Minarinski/2024ESWContest_free_1079/README.md

# 2024ESWContest_free_1079

## IoT-VehiCALL은 승객의 버스 탑승을 돕는 "승차벨" 시스템입니다.
### 대중교통 이용을 편리하게 하며, 교통약자의 접근성을 향상하고 버스 노선 운영을 효율적으로 할 수 있도록 합니다.
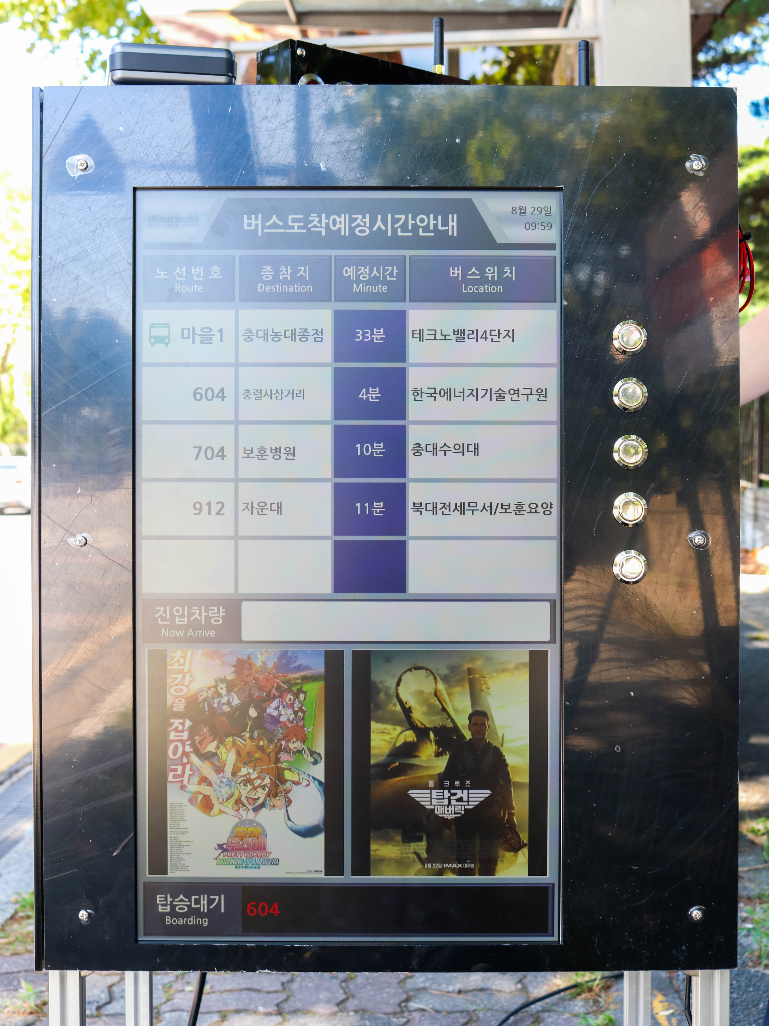
[picture p1: Remote_Device.jpg]

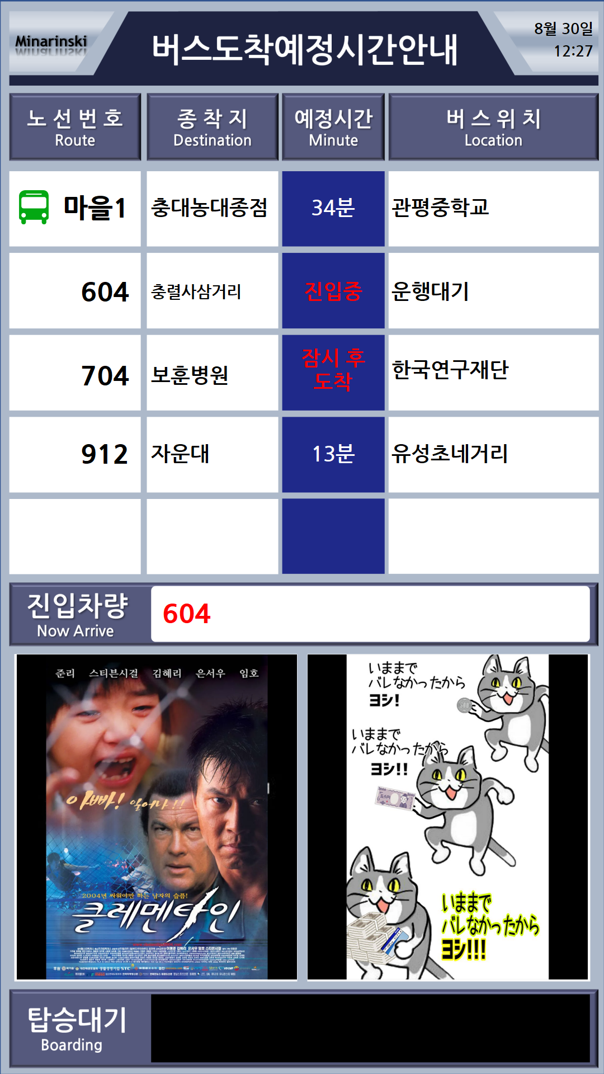
[picture p2: PyQt_GUI.PNG]

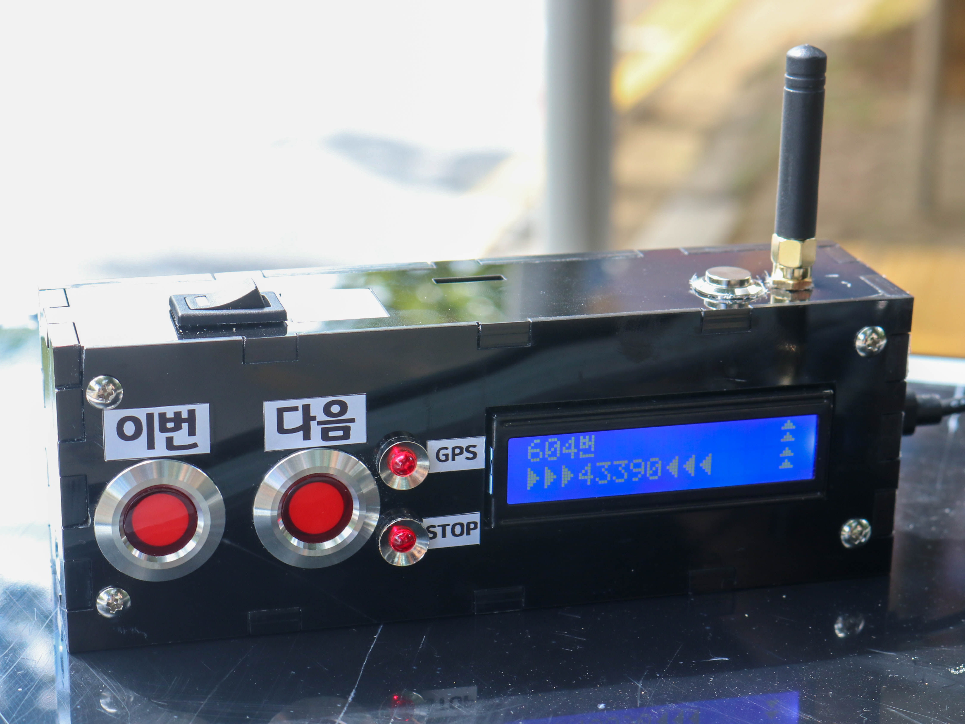
[picture p3: Local_Device.jpg]

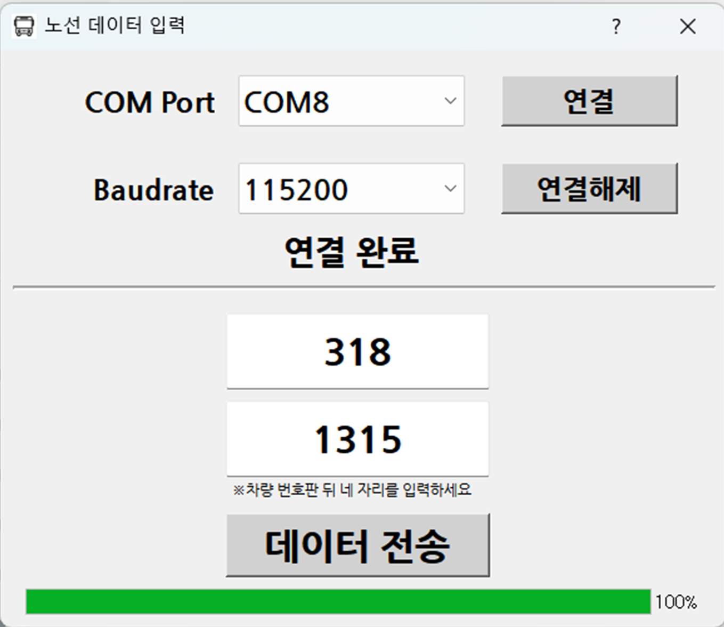
[picture p4: Bus_Data_Downloader.png]
