Minarinski/2024ESWContest_free_1079/PCB_Board/README.md

3D_View
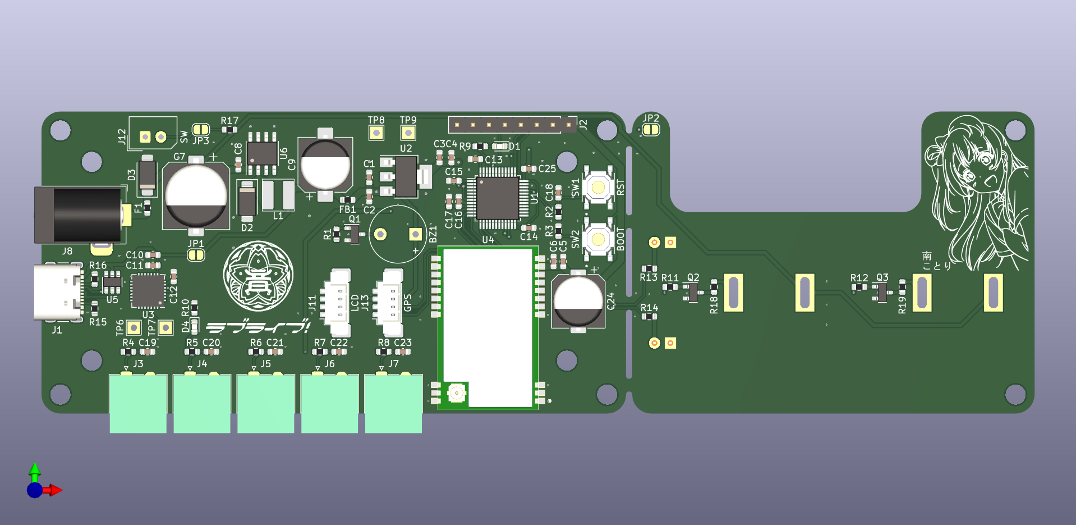
[picture p5: PCB_Board/3D_View.png]
3D_View

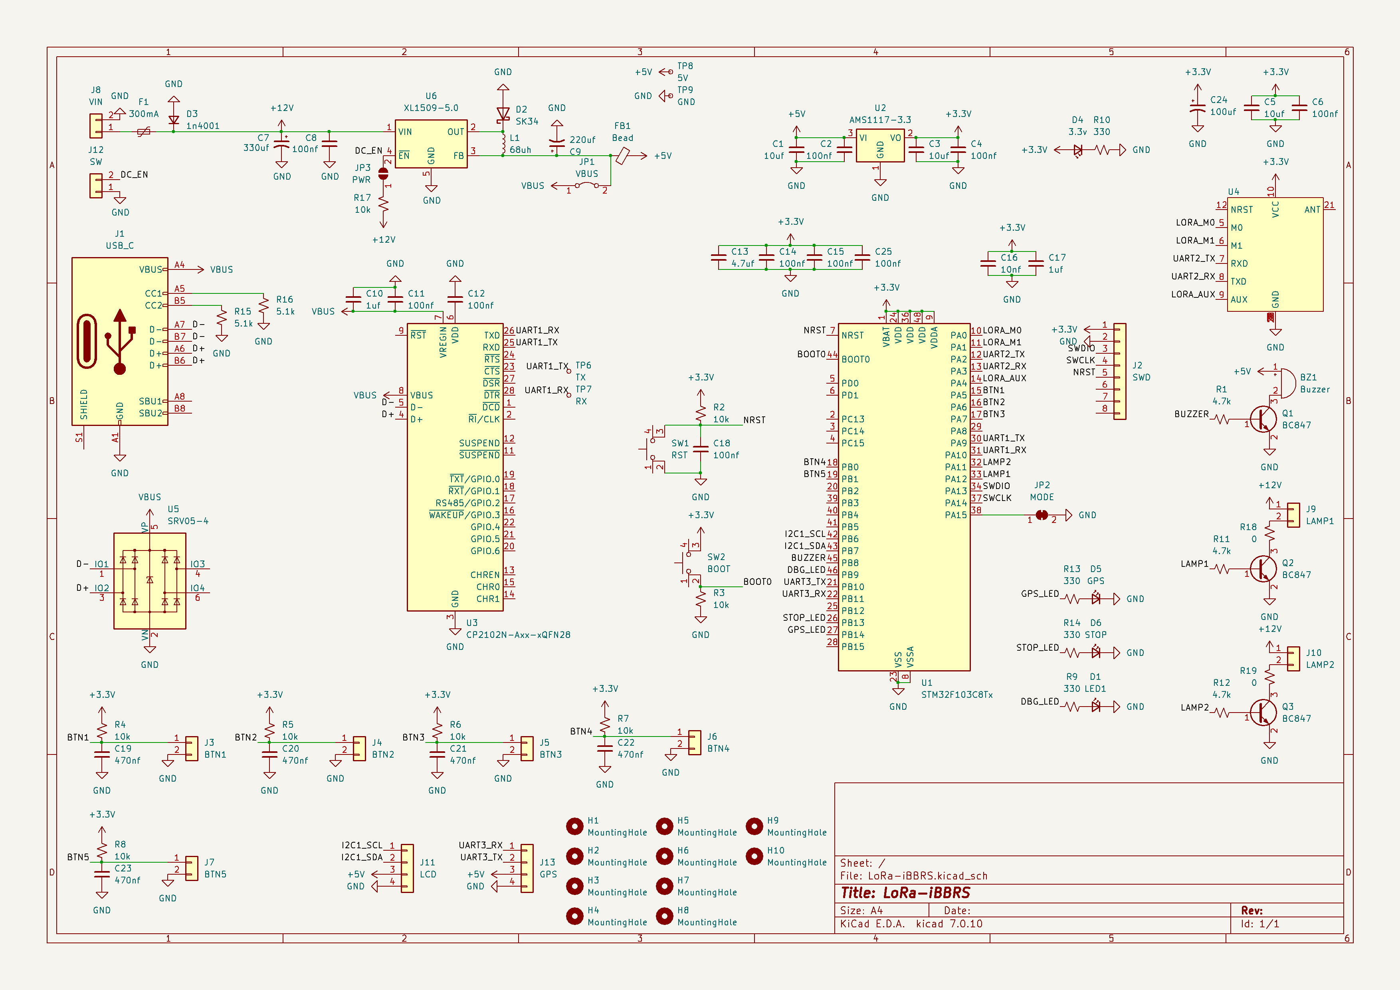
[picture p6: PCB_Board/Schematic.png]
