Minarinski/2024ESWContest_free_1079/Release/BusInfo/image/AD/1.png

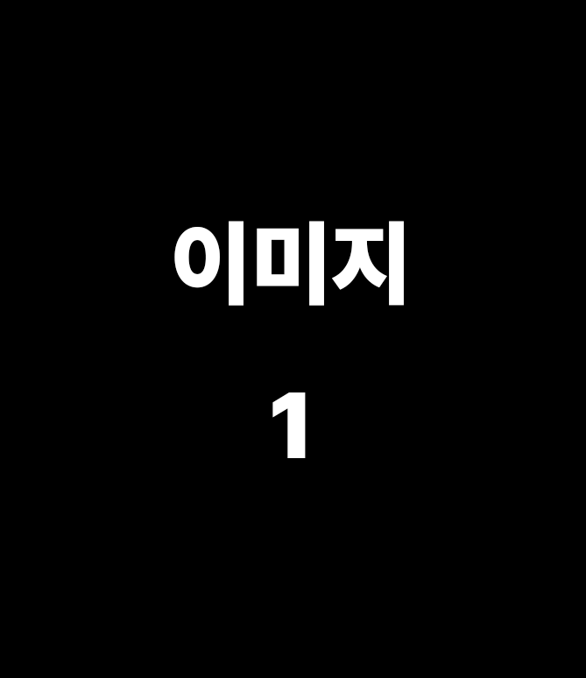
Release/BusInfo/image/AD/1.png
