Minarinski/2024ESWContest_free_1079/Release/BusInfo/image/asset/background.png

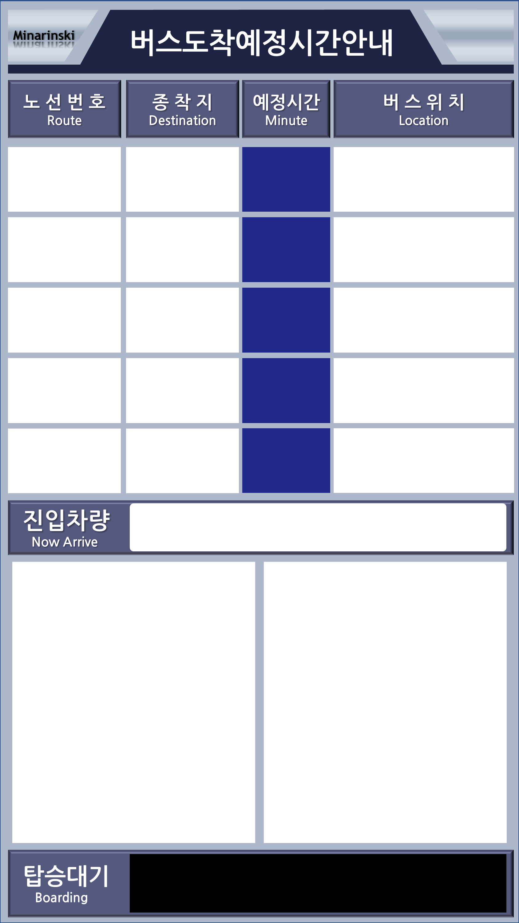
Release/BusInfo/image/asset/background.png
