Minarinski/2024ESWContest_free_1079/Release/BusInfo/image/asset/lowFloor.png

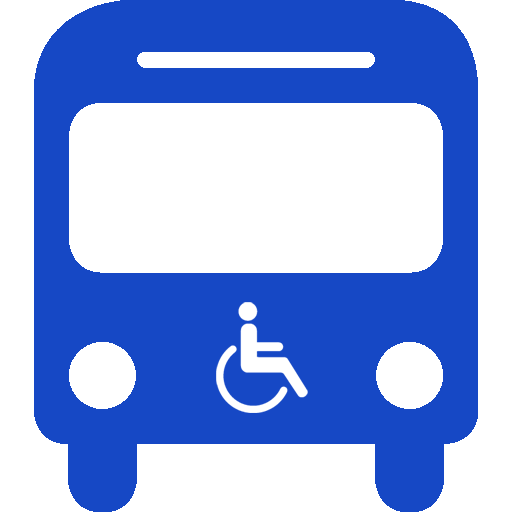
Release/BusInfo/image/asset/lowFloor.png
