Minarinski/2024ESWContest_free_1079/PCB_Board/LoRa-iBBRS/LoRa-iBBRS.kicad_pcb

## KiCad design PCB_Board/LoRa-iBBRS/LoRa-iBBRS.kicad_pcb (2024-09-06)

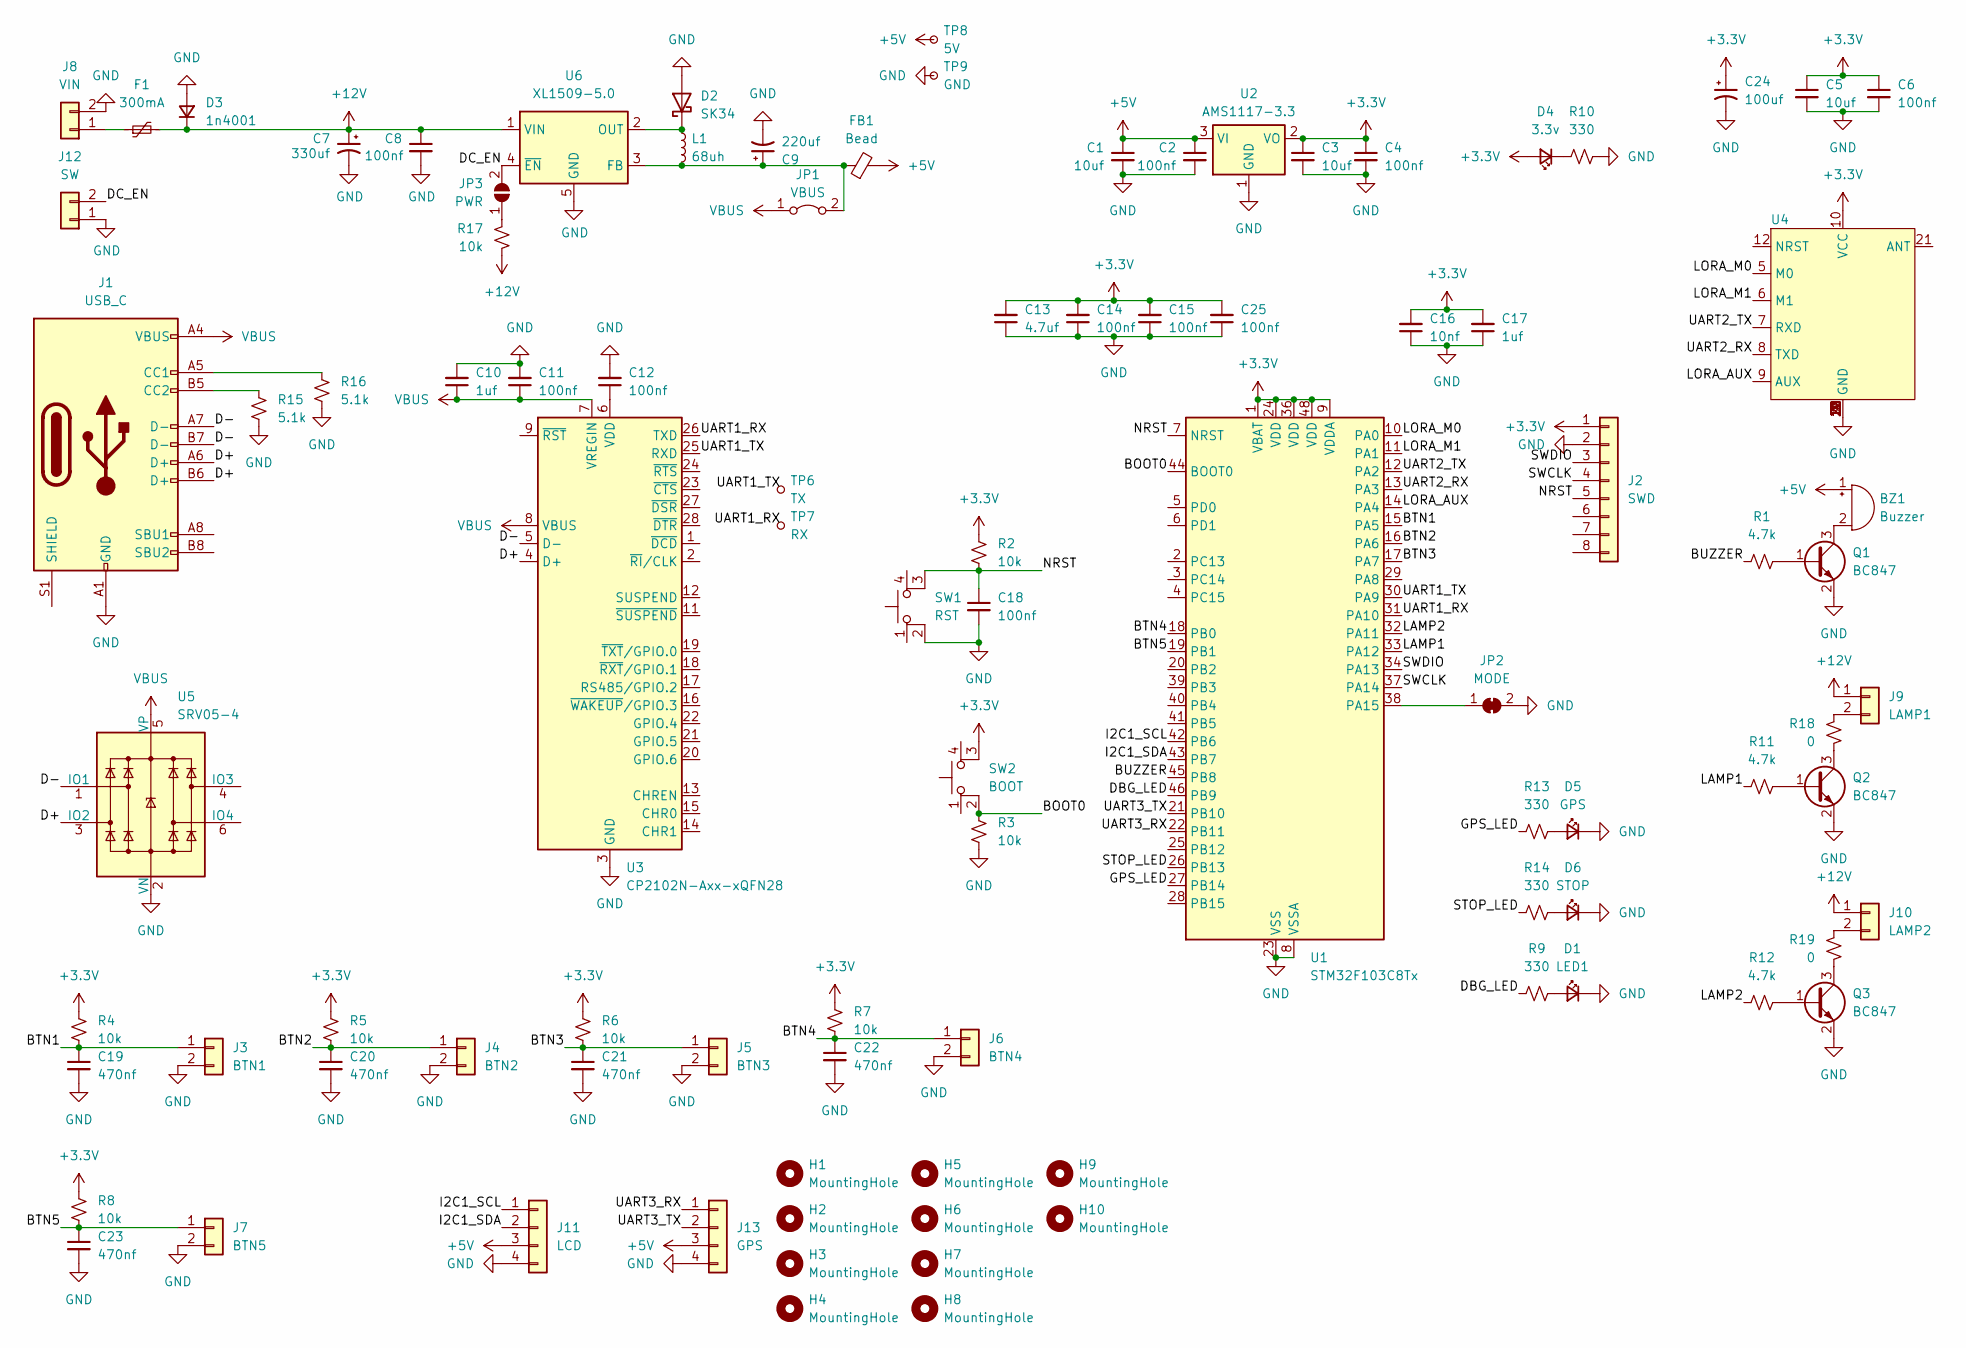
[picture p10: schematic LoRa-iBBRS.kicad_sch]

Parts:
BZ1: Buzzer; FQ-014
C1, C3, C5: 10uf; C_0603_1608Metric
C2, C4, C6, C8, C11, C12, C14, C15, C18, C25: 100nf; C_0603_1608Metric
C7: 330uf; CP_Elec_10x10.5; LCSC C336775
C9: 220uf; CP_Elec_8x10.5; LCSC C336709
C10, C17: 1uf; C_0603_1608Metric
C13: 4.7uf; C_0603_1608Metric
C16: 10nf; C_0603_1608Metric
C19, C20, C21, C22, C23: 470nf; C_0603_1608Metric
C24: 100uf; CP_Elec_8x6.5; LCSC C401616
D1: LED1; LED_0603_1608Metric
D2: SK34; D_SMA; LCSC C8678
D3: 1n4001; D_SMA
D4: 3.3v; LED_0603_1608Metric
D5: GPS; LED_D5.0mm
D6: STOP; LED_D5.0mm
F1: 300mA; Fuse_0603_1608Metric; LCSC C910820
FB1: Bead; Fuse_0603_1608Metric; LCSC C1002
H1, H2, H3, H4, H5, H6, H7, H8, H9, H10: MountingHole; MountingHole_3.2mm_M3
J1: USB_C; USB_C_Receptacle_GCT_USB4105-xx-A_16P_TopMnt_Horizontal; LCSC C2765186
J2: SWD; PinHeader_1x08_P2.54mm_Vertical
J3: BTN1; PhoenixContact_MC_1,5_2-G-3.81_1x02_P3.81mm_Horizontal; LCSC C507005
J4: BTN2; PhoenixContact_MC_1,5_2-G-3.81_1x02_P3.81mm_Horizontal; LCSC C507005
J5: BTN3; PhoenixContact_MC_1,5_2-G-3.81_1x02_P3.81mm_Horizontal; LCSC C507005
J6: BTN4; PhoenixContact_MC_1,5_2-G-3.81_1x02_P3.81mm_Horizontal; LCSC C507005
J7: BTN5; PhoenixContact_MC_1,5_2-G-3.81_1x02_P3.81mm_Horizontal; LCSC C507005
J8: VIN; BarrelJack_Horizontal
J9: LAMP1; QN22-LED
J10: LAMP2; QN22-LED
J11: LCD; Molex_PicoBlade_53398-0471_1x04-1MP_P1.25mm_Vertical; LCSC C234195
J12: SW; Molex_SPOX_5267-02A_1x02_P2.50mm_Vertical
J13: GPS; Molex_PicoBlade_53398-0471_1x04-1MP_P1.25mm_Vertical; LCSC C234195
JP1: VBUS; SolderJumper-2_P1.3mm_Bridged_RoundedPad1.0x1.5mm
JP2: MODE; SolderJumper-2_P1.3mm_Bridged_RoundedPad1.0x1.5mm
JP3: PWR; SolderJumper-2_P1.3mm_Open_RoundedPad1.0x1.5mm
L1: 68uh; Inductor_4.5x4mm; LCSC C324241
Q1, Q2, Q3: BC847; SOT-23; LCSC C181140
R1, R11, R12: 4.7k; R_0603_1608Metric
R2, R3, R4, R5, R6, R7, R8, R17: 10k; R_0603_1608Metric
R9, R10, R13, R14: 330; R_0603_1608Metric
R15, R16: 5.1k; R_0603_1608Metric
R18, R19: 0; R_0603_1608Metric
SW1: RST; SW_TS-1187A-B-A-B; LCSC C318884
SW2: BOOT; SW_TS-1187A-B-A-B; LCSC C318884
TP6: TX; TestPoint_THTPad_2.0x2.0mm_Drill1.0mm
TP7: RX; TestPoint_THTPad_2.0x2.0mm_Drill1.0mm
TP8: 5V; TestPoint_THTPad_2.0x2.0mm_Drill1.0mm
TP9: GND; TestPoint_THTPad_2.0x2.0mm_Drill1.0mm
U1: STM32F103C8Tx; LQFP-48_7x7mm_P0.5mm; LCSC C8734
U2: AMS1117-3.3; SOT-223-3_TabPin2; LCSC C6186
U3: CP2102N-Axx-xQFN28; QFN-28-1EP_5x5mm_P0.5mm_EP3.35x3.35mm; LCSC C6568
U4: E22-900T22S; LCSC C411289
U5: SRV05-4; SOT-23-6; LCSC C7420376
U6: XL1509-5.0; SOIC-8_3.9x4.9mm_P1.27mm; LCSC C61063

Connections:
+3.3V: C3.1, C4.1, C5.1, C6.1, C13.2, C14.2, C15.2, C16.2, C17.2, C24.1, C25.2, D4.2 (A), J2.1, R2.1, R4.1, R5.1, R6.1, R7.1, R8.1, SW2.3 (K), U1.1 (VBAT), U1.9 (VDDA), U1.24 (VDD), U1.36 (VDD), U1.48 (VDD), U2.2 (VO), U4.10 (VCC)
+5V: BZ1.1 (+), C1.1, C2.1, FB1.2, J11.3, J13.3, TP8.1, U2.3 (VI)
+12V: C7.1, C8.1, D3.1 (K), F1.2, J9.1, J10.1, R17.2, U6.1 (VIN)
/BOOT0: R3.1, SW2.2, U1.44 (BOOT0)
/BTN1: C19.1, J3.1, R4.2, U1.15 (PA5)
/BTN2: C20.1, J4.1, R5.2, U1.16 (PA6)
/BTN3: C21.1, J5.1, R6.2, U1.17 (PA7)
/BTN4: C22.1, J6.1, R7.2, U1.18 (PB0)
/BTN5: C23.1, J7.1, R8.2, U1.19 (PB1)
/BUZZER: R1.1, U1.45 (PB8)
/D+: J1.A6 (D+), J1.B6 (D+), U3.4 (D+), U5.3 (IO2)
/D-: J1.A7 (D-), J1.B7 (D-), U3.5 (D-), U5.1 (IO1)
/DBG_LED: R9.1, U1.46 (PB9)
/DC_EN: J12.2, JP3.2 (B), U6.4 (~EN)
/GPS_LED: R13.1, U1.27 (PB14)
/I2C1_SCL: J11.1, U1.42 (PB6)
/I2C1_SDA: J11.2, U1.43 (PB7)
/LAMP1: R11.1, U1.33 (PA12)
/LAMP2: R12.1, U1.32 (PA11)
/LORA_AUX: U1.14 (PA4), U4.9 (AUX)
/LORA_M0: U1.10 (PA0), U4.5 (M0)
/LORA_M1: U1.11 (PA1), U4.6 (M1)
/NRST: C18.1, J2.5, R2.2, SW1.3 (K), U1.7 (NRST)
/STOP_LED: R14.1, U1.26 (PB13)
/SWCLK: J2.4, U1.37 (PA14)
/SWDIO: J2.3, U1.34 (PA13)
/UART1_RX: TP7.1, U1.31 (PA10), U3.26 (TXD)
/UART1_TX: TP6.1, U1.30 (PA9), U3.25 (RXD)
/UART2_RX: U1.13 (PA3), U4.8 (TXD)
/UART2_TX: U1.12 (PA2), U4.7 (RXD)
/UART3_RX: J13.1, U1.22 (PB11)
/UART3_TX: J13.2, U1.21 (PB10)
GND: C1.2, C2.2, C3.2, C4.2, C5.2, C6.2, C7.2, C8.2, C9.2, C10.2, C11.2, C12.2, C13.1, C14.1, C15.1, C16.1, C17.1, C18.2, C19.2, C20.2, C21.2, C22.2, C23.2, C24.2, C25.1, D1.1 (K), D2.2 (A), D3.2 (A), D5.1 (K), D6.1 (K), J1.A1 (GND), J1.A12 (GND), J1.B1 (GND), J1.B12 (GND), J2.2, J3.2, J4.2, J5.2, J6.2, J7.2, J8.2, J11.4, J12.1, J13.4, JP2.2 (B), Q1.2 (E), Q2.2 (E), Q3.2 (E), R3.2, R10.2, R15.2, R16.2, SW1.2, TP9.1, U1.8 (VSSA), U1.23 (VSS), U1.35 (VSS), U1.47 (VSS), U2.1 (GND), U3.3 (GND), U3.29 (GND), U4.1 (GND), U4.2 (GND), U4.3 (GND), U4.4 (GND), U4.11 (GND), U4.13 (GND), U4.19 (GND), U4.20 (GND), U4.22 (GND), U5.2 (VN), U6.5 (GND), U6.6 (GND), U6.7 (GND), U6.8 (GND)
unnamed: BZ1.2 (-), Q1.3 (C)
unnamed: D1.2 (A), R9.2
unnamed: D2.1 (K), L1.1, U6.2 (OUT)
unnamed: D4.1 (K), R10.1
unnamed: D5.2 (A), R13.2
unnamed: D6.2 (A), R14.2
unnamed: J1.A5 (CC1), R16.1
unnamed: J1.B5 (CC2), R15.1
unnamed: F1.1, J8.1
unnamed: J9.2, R18.2
unnamed: J10.2, R19.2
unnamed: C9.1, FB1.1, JP1.2 (B), L1.2, U6.3 (FB)
unnamed: JP2.1 (A), U1.38 (PA15)
unnamed: JP3.1 (A), R17.1
unnamed: Q1.1 (B), R1.2
unnamed: Q2.1 (B), R11.2
unnamed: Q2.3 (C), R18.1
unnamed: Q3.1 (B), R12.2
unnamed: Q3.3 (C), R19.1
unnamed: C12.1, U3.6 (VDD)
VBUS: C10.1, C11.1, J1.A4 (VBUS), J1.A9 (VBUS), J1.B4 (VBUS), J1.B9 (VBUS), JP1.1 (A), U3.7 (VREGIN), U3.8 (VBUS), U5.5 (VP)

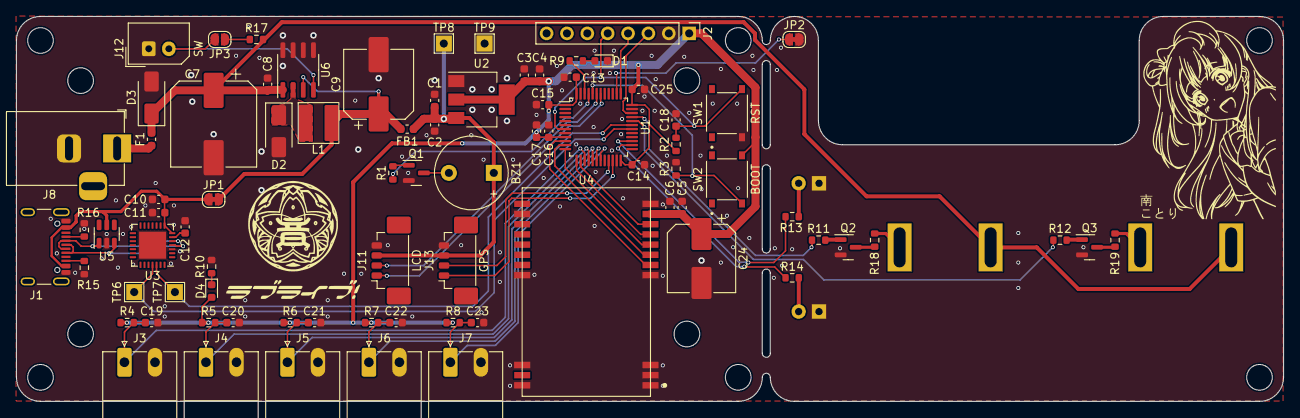
[picture p11: board LoRa-iBBRS.kicad_pcb from above]

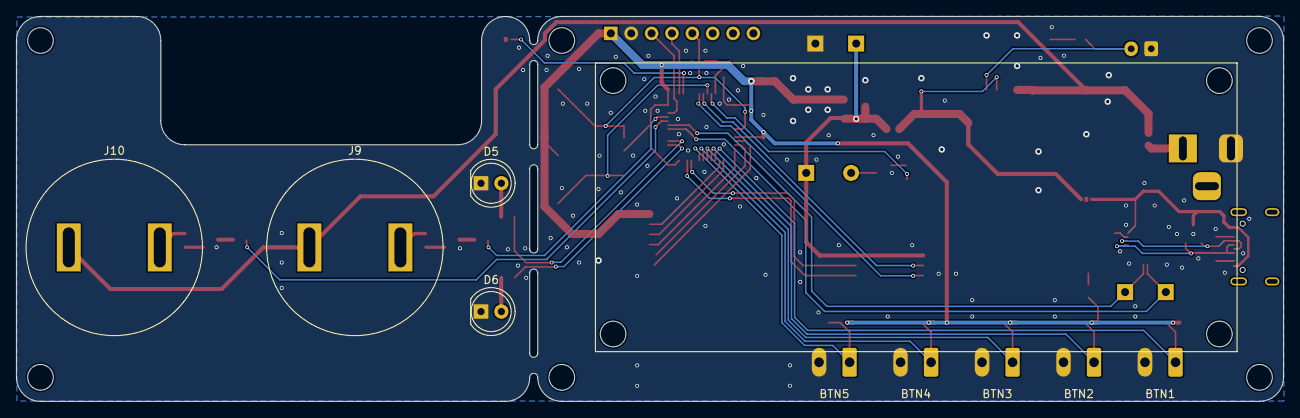
[picture p12: board LoRa-iBBRS.kicad_pcb from below]

Board: 2 copper layers, 158.0 x 48.0 mm, 95 parts (8 on the bottom side), 54 nets.
