Minarinski/2024ESWContest_free_1079/MCU_Firmware/Core/Src/main.c

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
/* Includes ------------------------------------------------------------------*/
#include "main.h"

/* USER CODE BEGIN Includes */
#include <stdio.h>
#include <string.h>
#include <stdlib.h>
#include <math.h>
#include "nmea_parse.h"
/* USER CODE END Includes */

/* USER CODE BEGIN PD */
#define DEFAULT_RF_FREQUENCY 920900000
#define EEPROM_BASE_ADDRESS 0x08080000
#define LCD_CGRAM_BASE_ADDR	0x40
#define CMD_LCD_ON_CURSOR 0x0E
#define CMD_LCD_ON 0x0C
#define CMD_LCD_CLEAR 0x01
#define CMD_LCD_CURSOR_LINE_1 0x80
#define CMD_LCD_CURSOR_LINE_2 0xC0
#define CMD_LCD_CURSOR_LEFT 0x10
#define CMD_LCD_CURSOR_RIGHT 0x14
#define LCD_ADDR (0x27 << 1)
#define LCD_PIN_RS    (1 << 0)
#define LCD_PIN_EN    (1 << 2)
#define LCD_BACKLIGHT (1 << 3)
#define LCD_DELAY_MS 5
/* USER CODE END PD */

I2C_HandleTypeDef hi2c1;

UART_HandleTypeDef huart1;
UART_HandleTypeDef huart2;
UART_HandleTypeDef huart3;
DMA_HandleTypeDef hdma_usart1_rx;
DMA_HandleTypeDef hdma_usart3_rx;

/* USER CODE BEGIN PV */
struct DataFlash {
	char busTP;
	char busNM[5];
	char busRouteno[5];
	char busStopID[8];
	char lati[16];
	char longi[16];
	uint8_t isPeople;
} data[150] = { 0 };

int nowIdx = 0;

uint8_t GPSLEDFlag = 0;

uint8_t NowBusStopFlag = 0;

uint8_t upDownFlag = 0;

/* USER CODE BEGIN PV */
#define RxBuffer_SIZE 512  //configure uart receive buffer size
#define DataBuffer_SIZE 512 //gather a few rxBuffer frames before parsing

// Functions for UART receiving, based on the DMA receive function, implementations may vary
uint16_t oldPos = 0;
uint16_t newPos = 0;
uint8_t RxBuffer[RxBuffer_SIZE];
uint8_t DataBuffer[DataBuffer_SIZE];

//create a GPS data structure
GPS myData;

uint16_t GPSRange = 0;
/* USER CODE END PV */

void SystemClock_Config(void);
static void MX_GPIO_Init(void);
static void MX_DMA_Init(void);
static void MX_I2C1_Init(void);
static void MX_USART1_UART_Init(void);
static void MX_USART2_UART_Init(void);
static void MX_USART3_UART_Init(void);
/* USER CODE BEGIN 0 */

void HAL_UARTEx_RxEventCallback(UART_HandleTypeDef *huart, uint16_t Size) {
	oldPos = newPos; //keep track of the last position in the buffer
	if (oldPos + Size > DataBuffer_SIZE) { //if the buffer is full, parse it, then reset the buffer

		uint16_t datatocopy = DataBuffer_SIZE - oldPos; // find out how much space is left in the main buffer
		memcpy((uint8_t*) DataBuffer + oldPos, RxBuffer, datatocopy); // copy data in that remaining space

		oldPos = 0;  // point to the start of the buffer
		memcpy((uint8_t*) DataBuffer, (uint8_t*) RxBuffer + datatocopy,
				(Size - datatocopy));  // copy the remaining data
		newPos = (Size - datatocopy);  // update the position
	} else {
		memcpy((uint8_t*) DataBuffer + oldPos, RxBuffer, Size); //copy received data to the buffer
		newPos = Size + oldPos; //update buffer position

	}
	HAL_UARTEx_ReceiveToIdle_DMA(&huart3, (uint8_t*) RxBuffer, RxBuffer_SIZE); //re-enable the DMA interrupt
	__HAL_DMA_DISABLE_IT(&hdma_usart3_rx, DMA_IT_HT); //disable the half transfer interrupt
}

//LCD ============================================
HAL_StatusTypeDef LCD_SendInternal(uint8_t lcd_addr, uint8_t data,
		uint8_t flags) {
	HAL_StatusTypeDef res;
	for (;;) {
		res = HAL_I2C_IsDeviceReady(&hi2c1, lcd_addr, 1, HAL_MAX_DELAY);
		if (res == HAL_OK)
			break;
	}

	uint8_t up = data & 0xF0;
	uint8_t lo = (data << 4) & 0xF0;

	uint8_t data_arr[4];
	data_arr[0] = up | flags | LCD_BACKLIGHT | LCD_PIN_EN;
	data_arr[1] = up | flags | LCD_BACKLIGHT;
	data_arr[2] = lo | flags | LCD_BACKLIGHT | LCD_PIN_EN;
	data_arr[3] = lo | flags | LCD_BACKLIGHT;

	res = HAL_I2C_Master_Transmit(&hi2c1, lcd_addr, data_arr, sizeof(data_arr),
	HAL_MAX_DELAY);
	HAL_Delay(LCD_DELAY_MS);
	return res;
}

void LCD_SendCommand(uint8_t lcd_addr, uint8_t cmd) {
	LCD_SendInternal(lcd_addr, cmd, 0);
}

void LCD_SendData(uint8_t lcd_addr, uint8_t data) {
	LCD_SendInternal(lcd_addr, data, LCD_PIN_RS);
}

void LCD_Init(uint8_t lcd_addr) {
	// 4-bit mode, 2 lines, 5x7 format
	LCD_SendCommand(lcd_addr, 0x30);
	// display & cursor home (keep this!)
	LCD_SendCommand(lcd_addr, 0x02);
	// display on, right shift, underline off, blink off
	LCD_SendCommand(lcd_addr, CMD_LCD_ON);
	// clear display (optional here)
	LCD_SendCommand(lcd_addr, CMD_LCD_CLEAR);
}

void LCD_SendString(uint8_t lcd_addr, char *str) {
	while (*str) {
		LCD_SendData(lcd_addr, (uint8_t) (*str));
		str++;
	}
}

void LCD_SET_CGRAM(uint8_t lcd_addr, uint8_t addr, uint8_t *data) {
	uint8_t start_addr = LCD_CGRAM_BASE_ADDR | (addr << 3);
	LCD_SendCommand(lcd_addr, start_addr);
	for (int i = 0; i < 8; i++) {
		LCD_SendData(lcd_addr, data[i]);
	}
}

void LCD_Write_Info(struct DataFlash nowData, struct DataFlash nextData) {
	LCD_SendCommand(LCD_ADDR, CMD_LCD_CLEAR); //Clear
	LCD_SendCommand(LCD_ADDR, CMD_LCD_CURSOR_LINE_1);
	LCD_SendString(LCD_ADDR, nowData.busRouteno);
	LCD_SendData(LCD_ADDR, 0);
	for (int i = 0; i < 11; i++) {
		LCD_SendCommand(LCD_ADDR, CMD_LCD_CURSOR_RIGHT);
	}
	//printf("flag = %d\r\n", upDownFlag);
	if (!upDownFlag)
		LCD_SendData(LCD_ADDR, 1);
	else
		LCD_SendData(LCD_ADDR, 2);
	LCD_SendCommand(LCD_ADDR, CMD_LCD_CURSOR_LINE_2);
	LCD_SendData(LCD_ADDR, 3);
	LCD_SendString(LCD_ADDR, nowData.busStopID);
	LCD_SendData(LCD_ADDR, 3);
	LCD_SendData(LCD_ADDR, 3);
	LCD_SendData(LCD_ADDR, 3);
	LCD_SendString(LCD_ADDR, nextData.busStopID);
	for (int i = 0; i < 1; i++) {
		LCD_SendCommand(LCD_ADDR, CMD_LCD_CURSOR_RIGHT);
	}
	if (!upDownFlag)
		LCD_SendData(LCD_ADDR, 1);
	else
		LCD_SendData(LCD_ADDR, 2);
}

void updateLCD() {
	LCD_Write_Info(data[nowIdx], data[nowIdx + 1]);
}

void notGPSLCD() {
	LCD_SendCommand(LCD_ADDR, CMD_LCD_CLEAR); //Clear
	LCD_SendCommand(LCD_ADDR, CMD_LCD_CURSOR_LINE_1);
	LCD_SendString(LCD_ADDR, data[0].busRouteno);
	LCD_SendData(LCD_ADDR, 0);
	for (int i = 0; i < 11; i++) {
		LCD_SendCommand(LCD_ADDR, CMD_LCD_CURSOR_RIGHT);
	}
	LCD_SendData(LCD_ADDR, 1);
	LCD_SendCommand(LCD_ADDR, CMD_LCD_CURSOR_LINE_2);
	LCD_SendData(LCD_ADDR, 3);
	LCD_SendString(LCD_ADDR, "-----");
	LCD_SendData(LCD_ADDR, 3);
	LCD_SendData(LCD_ADDR, 3);
	LCD_SendData(LCD_ADDR, 3);
	LCD_SendString(LCD_ADDR, "-----");
	for (int i = 0; i < 1; i++) {
		LCD_SendCommand(LCD_ADDR, CMD_LCD_CURSOR_RIGHT);
	}
	LCD_SendData(LCD_ADDR, 1);
}

void LCD_Write_Arrive(struct DataFlash nowData) {
	LCD_SendCommand(LCD_ADDR, CMD_LCD_CLEAR); //Clear
	LCD_SendCommand(LCD_ADDR, CMD_LCD_CURSOR_LINE_1);
	LCD_SendString(LCD_ADDR, nowData.busRouteno);
	LCD_SendData(LCD_ADDR, 0);
	for (int i = 0; i < 11; i++) {
		LCD_SendCommand(LCD_ADDR, CMD_LCD_CURSOR_RIGHT);
	}
	LCD_SendData(LCD_ADDR, 1);
	LCD_SendCommand(LCD_ADDR, CMD_LCD_CURSOR_LINE_2);
	LCD_SendData(LCD_ADDR, 3);
	LCD_SendData(LCD_ADDR, 3);
	LCD_SendData(LCD_ADDR, 3);
	LCD_SendString(LCD_ADDR, nowData.busStopID);
	LCD_SendData(LCD_ADDR, 4);
	LCD_SendData(LCD_ADDR, 4);
	LCD_SendData(LCD_ADDR, 4);
	for (int i = 0; i < 4; i++) {
		LCD_SendCommand(LCD_ADDR, CMD_LCD_CURSOR_RIGHT);
	}
	LCD_SendData(LCD_ADDR, 1);
}

//Flash===========================================================

int dataIdx = 0;

void Flash_Unlock(void) {
	FLASH->KEYR = 0x45670123;  // Key1
	FLASH->KEYR = 0xCDEF89AB;  // Key2
}

void Flash_Lock(void) {
	FLASH->CR |= FLASH_CR_LOCK;
}

void Flash_Write(uint32_t address, uint8_t data) {
	while (FLASH->SR & FLASH_SR_BSY)
		;  // Busy flag 체크

	FLASH->CR |= FLASH_CR_PG;  // Programming mode

	*(__IO uint16_t*) address = data;  // data 기록

	while (FLASH->SR & FLASH_SR_BSY)
		;  // Busy flag 체크

	FLASH->CR &= ~FLASH_CR_PG;  // Programming mode
}

void Flash_Write_StrInt(uint32_t address, uint8_t *StrData) {
	Flash_Unlock();
	uint16_t value = (uint16_t) strtol((const char*) StrData, NULL, 10);
	Flash_Write(address, value);
	Flash_Lock();
}

uint32_t Flash_Write_Char(uint32_t address, uint8_t CharData) {
	Flash_Unlock();
	Flash_Write(address, CharData);
	Flash_Lock();
	return address + 0x02;
}

uint32_t Flash_Write_Str(uint32_t address, uint8_t *StrData) {
	for (int i = 0; i < strlen((char*) StrData); i++) {
		address = Flash_Write_Char(address, StrData[i]);
	}
	//printf("%x\r\n", address);
	return address;
}

uint32_t Flash_Write_Data(uint32_t address, uint8_t *StrData) {
	char *token;

	token = strtok(StrData, ",");
	if (token[0] == 'D') {
		token = strtok(NULL, ",");
		if (token != NULL) {
			data[dataIdx].busTP = token[0];
			address = Flash_Write_Char(address, data[dataIdx].busTP);
			address = Flash_Write_Char(address, ',');
		}

		token = strtok(NULL, ",");
		if (token != NULL) {
			strncpy(data[dataIdx].busNM, token,
					sizeof(data[dataIdx].busNM) - 1);
			data[dataIdx].busNM[sizeof(data[dataIdx].busNM) - 1] = '\0';
			address = Flash_Write_Str(address, data[dataIdx].busNM);
			address = Flash_Write_Char(address, ',');
		}

		token = strtok(NULL, ",");
		if (token != NULL) {
			strncpy(data[dataIdx].busRouteno, token,
					sizeof(data[dataIdx].busRouteno) - 1);
			data[dataIdx].busRouteno[sizeof(data[dataIdx].busRouteno) - 1] =
					'\0';
			address = Flash_Write_Str(address, data[dataIdx].busRouteno);
			address = Flash_Write_Char(address, ',');
		}

		token = strtok(NULL, ",");
		if (token != NULL) {
			strncpy(data[dataIdx].busStopID, token,
					sizeof(data[dataIdx].busStopID) - 1);
			data[dataIdx].busStopID[sizeof(data[dataIdx].busStopID) - 1] = '\0';
			address = Flash_Write_Str(address, data[dataIdx].busStopID);
			address = Flash_Write_Char(address, ',');
		}
	} else {
		token = strtok(NULL, ",");
		if (token != NULL) {
			strncpy(data[dataIdx].lati, token, sizeof(data[dataIdx].lati) - 1);
			data[dataIdx].lati[sizeof(data[dataIdx].lati) - 1] = '\0';
			address = Flash_Write_Str(address, data[dataIdx].lati);
			address = Flash_Write_Char(address, ',');
		}

		token = strtok(NULL, ",");
		if (token != NULL) {
			strncpy(data[dataIdx].longi, token,
					sizeof(data[dataIdx].longi) - 1);
			data[dataIdx].longi[sizeof(data[dataIdx].longi) - 1] = '\0';
			address = Flash_Write_Str(address, data[dataIdx].longi);
			address = Flash_Write_Char(address, '!');
		}
		dataIdx += 1;
		if (dataIdx == 2) {
//			LCD_SendCommand(LCD_ADDR, CMD_LCD_CLEAR); //Clear
//			LCD_SendCommand(LCD_ADDR, CMD_LCD_CURSOR_LINE_1);
//			LCD_SendString(LCD_ADDR, "DATA DOWNLOAD");
//			LCD_SendCommand(LCD_ADDR, CMD_LCD_CURSOR_LINE_2);
//			LCD_SendString(LCD_ADDR, "SUCCESS");
		}
	}
//	printf("busNM:%s, busRouteNo:%s, BusStopID:%s, lati:%s, longi:%s\r\n",
//			data.busNM, data.busRouteno, data.busStopID, data.lati, data.longi);
	return address;
}

uint16_t Flash_Read(uint32_t address) {
	return *(__IO uint16_t*) address; // address data return
}

void Flash_Erase_Page(uint32_t address) {
	Flash_Unlock();

	FLASH->CR |= FLASH_CR_PER;   // Page Erase bit set
	FLASH->AR = address;         // Page Erase address
	FLASH->CR |= FLASH_CR_STRT;

	while (FLASH->SR & FLASH_SR_BSY)
		;  // page Erase end

	FLASH->CR &= ~FLASH_CR_PER;  // Page Erase bit reset

	Flash_Lock();
}

void splitData(char *strData) {
	char *token;

	token = strtok(strData, ","); // TP
	data[dataIdx].busTP = token[0];

	token = strtok(NULL, ","); // CarNM
	strncpy(data[dataIdx].busNM, token, sizeof(data[dataIdx].busNM) - 1);

	token = strtok(NULL, ","); // RouteNo
	strncpy(data[dataIdx].busRouteno, token,
			sizeof(data[dataIdx].busRouteno) - 1);

	token = strtok(NULL, ","); // StopID
	strncpy(data[dataIdx].busStopID, token,
			5);

	token = strtok(NULL, ","); // lati
	strncpy(data[dataIdx].lati, token, sizeof(data[dataIdx].lati) - 1);

	token = strtok(NULL, "!"); // longi
	strncpy(data[dataIdx].longi, token, sizeof(data[dataIdx].longi) - 1);
}

uint32_t CallData(uint32_t address) {
	char a[70] = { 0, };
	int i = 0;
	while (1) {
		a[i] = (char) Flash_Read(address);
		address += 0x02;
		if (a[i] == 0xFF) {
			return address;
		}
		if (a[i] == '!') {
			splitData(a);
			dataIdx += 1;
			i = -1;
			memset(a, 0, 60);
		}
		i += 1;
	}
}

void Flash_Clear() {
	Flash_Erase_Page(0x0800CC00);
	Flash_Erase_Page(0x0800D000);
	Flash_Erase_Page(0x0800D400);
	Flash_Erase_Page(0x0800D800);
	Flash_Erase_Page(0x0800DC00);
	Flash_Erase_Page(0x0800E000);
	Flash_Erase_Page(0x0800E400);
	Flash_Erase_Page(0x0800E800);
	Flash_Erase_Page(0x0800EC00);
	Flash_Erase_Page(0x0800F000);
	Flash_Erase_Page(0x0800F400);
	Flash_Erase_Page(0x0800F800);
	Flash_Erase_Page(0x0800FC00);

}

// GPS=======================================================
char latitude[16];
char longitude[16];

double convertToDecimalDegrees(const char *coordinate, char type) {
	int degrees;
	double minutes;
	double decimalDegrees;

	if (type == 'L') { // Latitude
		degrees = (coordinate[0] - '0') * 10 + (coordinate[1] - '0'); // dd
		minutes = atof(coordinate + 2); // mm.mmmm
	} else if (type == 'G') { // Longitude
		degrees = (coordinate[0] - '0') * 100 + (coordinate[1] - '0') * 10
				+ (coordinate[2] - '0'); // ddd
		minutes = atof(coordinate + 3); // mm.mmmm
	} else {
		printf("Invalid type\n");
		return -1;
	}
	decimalDegrees = degrees + (minutes / 60.0);

	return decimalDegrees;
}

void parseGPSData(uint8_t *buffer, uint16_t size) {
	char *nmeaGGA = NULL;
	double la, lo;
	//xprintf("%s", (char*)buffer);
	nmeaGGA = strstr((char*) buffer, "GLL");
	if (nmeaGGA != NULL) {
		char *token;

		token = strtok(nmeaGGA, ",");


		token = strtok(NULL, ","); //latitude
		if (token != NULL) {
			strncpy(latitude, token, sizeof(latitude) - 1);
			latitude[sizeof(latitude) - 1] = '\0';
			la = convertToDecimalDegrees(latitude, 'L');
		}

		token = strtok(NULL, ",");


		token = strtok(NULL, ","); //longitude
		if (token != NULL) {
			strncpy(longitude, token, sizeof(longitude) - 1);
			longitude[sizeof(longitude) - 1] = '\0';
			lo = convertToDecimalDegrees(longitude, 'G');
		}

		token = strtok(NULL, ",");

		printf("\r\nLatitude: %.6f, Longitude: %.6f\r\n", la, lo);
		if (la >= 200 || lo >= 200) {
			GPSLEDFlag = 0;
		} else {
			GPSLEDFlag = 1;
		}
		CheckGPS(la, lo);
	}
}

int checkGPSCnt = 0;

void CheckGPS(double nowLati, double nowLongi) {
	double busStopLati = atof(data[nowIdx].lati);
	double busStopLongi = atof(data[nowIdx].longi);
	//printf("La : %f, La1 : %f\r\n", busStopLati - 0.00009, busStopLati + 0.00009);
	//printf("NowLa : %f, NowLo : %f\r\n", nowLati, nowLongi);
	//printf("First : %d\r\n", nowLati >= (busStopLati - 0.00009)
	//		&& nowLati <= (busStopLati + 0.00009));
	if (nowLati >= (busStopLati - (0.000009 * GPSRange))
			&& nowLati <= (busStopLati + (0.000009 * GPSRange))) {
		if (nowLongi >= (busStopLongi - (0.000011 * GPSRange))
				&& nowLongi <= (busStopLongi + (0.000011 * GPSRange))) {
			checkGPSCnt++;
			//printf("Check!!!!!!!!\r\b");
		}
	}
}
double nowSum = 999;
int idxMin = -1;
void NowBusStop(double nowLati, double nowLongi) {
	double busStopLati = 0;
	double busStopLongi = 0;
	for (int i = 0; i < 150; i++) {
		busStopLati = atof(data[i].lati);
		busStopLongi = atof(data[i].longi);
		if (nowLati >= (busStopLati - (0.000009 * GPSRange))
				&& nowLati <= (busStopLati + (0.000009 * GPSRange))) {
			if (nowLongi >= (busStopLongi - (0.000011 * GPSRange))
					&& nowLongi <= (busStopLongi + (0.000011 * GPSRange))) {
				printf("\r\n%d!!!!!!!!\r\n\r\n", i);
				if (nowSum
						> fabs(nowLati - busStopLati)
								+ fabs(nowLongi - busStopLongi)) {
					nowSum = fabs(nowLati - busStopLati)
							+ fabs(nowLongi - busStopLongi);
					idxMin = i;
				}

				break;
			}
		}
	}
	if (idxMin != -1) {
		nowIdx = idxMin;
		NowBusStopFlag = 1;
	}
}
//==============================================================================
//LoRa
#define LoRa_RX_BUFFER_SIZE 64

uint8_t LoRaRxBuffer[LoRa_RX_BUFFER_SIZE];
volatile uint8_t LoRaRxEnd = 0;
uint8_t LoRaRxData[11];
uint8_t LoRaLen = 0;

void SetMode(uint8_t mode) {
	switch (mode) {
	case 0:
		HAL_GPIO_WritePin(GPIOA, LORA_M0_Pin, GPIO_PIN_RESET);
		HAL_GPIO_WritePin(GPIOA, LORA_M1_Pin, GPIO_PIN_RESET);
		break;
	case 1:
		HAL_GPIO_WritePin(GPIOA, LORA_M0_Pin, GPIO_PIN_SET);
		HAL_GPIO_WritePin(GPIOA, LORA_M1_Pin, GPIO_PIN_RESET);
		break;
	case 2:
		HAL_GPIO_WritePin(GPIOA, LORA_M0_Pin, GPIO_PIN_RESET);
		HAL_GPIO_WritePin(GPIOA, LORA_M1_Pin, GPIO_PIN_SET);
		break;
	case 3:
		HAL_GPIO_WritePin(GPIOA, LORA_M0_Pin, GPIO_PIN_SET);
		HAL_GPIO_WritePin(GPIOA, LORA_M1_Pin, GPIO_PIN_SET);
		break;
	}
}

void LoRa_SendData(uint8_t *data, uint16_t length) {
	// AUX
	while (HAL_GPIO_ReadPin(LORA_AUX_GPIO_Port, LORA_AUX_Pin) == GPIO_PIN_RESET)
		;

	HAL_UART_Transmit(&huart2, data, length, HAL_MAX_DELAY);
}

int help = 0;
int routeNo = 0;
int busNM = 0;
int arsID = 0;

int loraFlag = 0;

void parseLora(uint8_t *loraData) {

	if (loraData[1] == '0') {
		char *token;

		token = strtok(loraData, "@");
		arsID = atoi(token);
		printf("\r\narsID : %d!!!!!!\r\n\r\n", arsID);

		for (int i = 0; i < 150; i++) {
			if (atoi(data[i].busRouteno) != routeNo) {
				printf("\r\nNOT ROUTENO, %d\r\n\r\n",i);
				break;
			}
			if (atoi(data[i].busNM) != busNM) {
				printf("\r\nNOT busNM\r\n\r\n");
				break;
			}
			if (atoi(data[i].busStopID) == arsID) {
				data[i].isPeople = help;
				printf("\r\n%d\r\n\r\n", i);
				loraFlag = 1;
//				HAL_GPIO_WritePin(GPIOB, GPIO_PIN_8, 1); //BUZZER
//				HAL_Delay(100);
//				HAL_GPIO_WritePin(GPIOB, GPIO_PIN_8, 0); //BUZZER
				break;
			}
		}
	} else {
		help = loraData[0] - '0';
		routeNo = (loraData[2] - '0') * 100 + (loraData[3] - '0') * 10
				+ (loraData[4] - '0');
		busNM = (loraData[6] - '0') * 1000 + (loraData[7] - '0') * 100
				+ (loraData[8] - '0') * 10 + (loraData[9] - '0');
		printf("\r\nhelp : %d, routeNo : %d, busNM : %d\r\n\r\n", help, routeNo,
				busNM);
	}

}

//LCD=======================================================================
uint8_t BNumber[8] = { 0x15, 0x1d, 0x17, 0x1d, 0x1, 0x10, 0x1f };
uint8_t BUp[8] = { 0x4, 0xe, 0x1f, 0x0, 0x4, 0xe, 0x1f };
uint8_t BDown[8] = { 0x1f, 0xe, 0x4, 0x0, 0x1f, 0xe, 0x4 };
uint8_t BRight[8] = { 0x10, 0x18, 0x1c, 0x1e, 0x1c, 0x18, 0x10 };
uint8_t BLeft[8] = { 0x01, 0x03, 0x07, 0x0f, 0x07, 0x03, 0x01 };


//UART=======================================================================
unsigned char UART_Print_Port = 0; //0 = USB, 1 = LoRa, 2 = GPS
uint8_t UART1_Rx_Data[1];

uint8_t flagUart3 = 0;

uint8_t UART1_Rx_Buffer[50];
uint8_t UART1_Len = 0;

unsigned char UART1_Rx_End = 0;

#define RX3_BUFFER_SIZE 256
uint8_t rxBuffer[RX3_BUFFER_SIZE];
uint8_t nmeaBuffer[RX3_BUFFER_SIZE];
uint8_t dataReceived = 0;

uint8_t modeFlag = 0;
uint8_t pushingFlag = 0;

int _write(int file, unsigned char *p, int len) {
	if (UART_Print_Port == 0) {
		HAL_UART_Transmit(&huart1, p, len, 10);
	} else if (UART_Print_Port == 1) {
		HAL_UART_Transmit(&huart2, p, len, 10);
	} else if (UART_Print_Port == 2) {
		HAL_UART_Transmit(&huart3, p, len, 10);
	}
	return len;
}
#ifdef __GNUC__
#define PUTCHAR_PROTOTYPE int __io_putchar(int ch)
#else
#define PUTCHAR_PROTOTYPE int fputc(int ch, FILE *f)
#endif
PUTCHAR_PROTOTYPE {
	if (UART_Print_Port == 0) {
		HAL_UART_Transmit(&huart1, (uint8_t*) &ch, 1, 0xFFFF);
	} else if (UART_Print_Port == 1) {
		HAL_UART_Transmit(&huart2, (uint8_t*) &ch, 1, 0xFFFF);
	} else if (UART_Print_Port == 2) {
		HAL_UART_Transmit(&huart3, (uint8_t*) &ch, 1, 0xFFFF);
	}
	return ch;
}

//Tick=================================================================
uint32_t GPSTick = 0;
uint32_t LoRaTick = 0;
uint32_t GPSFIXTick = 0;
uint32_t ArriveTick = 0;
uint32_t BtnTick = 0;

int asd = 2;

int helpBuzzer = 0;

uint8_t LoRaModeFlag = 0;

/* USER CODE END 0 */

/**
  * @brief  The application entry point.
  * @retval int
  */
int main(void)
{

  /* MCU Configuration--------------------------------------------------------*/

  /* Reset of all peripherals, Initializes the Flash interface and the Systick. */
  HAL_Init();

  /* USER CODE BEGIN Init */
	HAL_Delay(1000);
  /* USER CODE END Init */

  /* Configure the system clock */
  SystemClock_Config();

  /* Initialize all configured peripherals */
  MX_GPIO_Init();
  MX_DMA_Init();
  MX_I2C1_Init();
  MX_USART1_UART_Init();
  MX_USART2_UART_Init();
  MX_USART3_UART_Init();
  /* USER CODE BEGIN 2 */
	HAL_UART_Receive_DMA(&huart1, UART1_Rx_Buffer, 20);
	HAL_UART_Receive_IT(&huart2, LoRaRxData, 10);
	HAL_UART_Receive_DMA(&huart3, DataBuffer, RxBuffer_SIZE);
	setvbuf(stdout, NULL, _IONBF, 0);
	//	printf("HELL WORLD\r\n");
	LCD_Init(LCD_ADDR);
	LCD_SET_CGRAM(LCD_ADDR, 0x00, BNumber);
	LCD_SET_CGRAM(LCD_ADDR, 0x01, BUp);
	LCD_SET_CGRAM(LCD_ADDR, 0x02, BDown);
	LCD_SET_CGRAM(LCD_ADDR, 0x03, BRight);
	LCD_SET_CGRAM(LCD_ADDR, 0x04, BLeft);
//	LCD_SendCommand(LCD_ADDR, CMD_LCD_CLEAR); //Clear
//	LCD_SendCommand(LCD_ADDR, CMD_LCD_CURSOR_LINE_1);
//	LCD_SendString(LCD_ADDR, "604");
//	LCD_SendData(LCD_ADDR, 0);
//	for (int i = 0; i < 11; i++) {
//		LCD_SendCommand(LCD_ADDR, CMD_LCD_CURSOR_RIGHT);
//	}
//	LCD_SendData(LCD_ADDR, 1);
//	LCD_SendCommand(LCD_ADDR, CMD_LCD_CURSOR_LINE_2);
//	LCD_SendData(LCD_ADDR, 3);
//	LCD_SendString(LCD_ADDR, "43420");
//	LCD_SendData(LCD_ADDR, 3);
//	LCD_SendData(LCD_ADDR, 3);
//	LCD_SendData(LCD_ADDR, 3);
//	LCD_SendString(LCD_ADDR, "43080");
//	for (int i = 0; i < 1; i++) {
//		LCD_SendCommand(LCD_ADDR, CMD_LCD_CURSOR_RIGHT);
//	}
//	LCD_SendData(LCD_ADDR, 1);

	//flash
	uint32_t GPSRangeFlashAddress = 0x0800C400;
	uint32_t ModeFlashAddress = 0x0800CB00;
	uint32_t DataFlashAddress = 0x0800CC00;
	uint16_t InfoModeFlag = Flash_Read(ModeFlashAddress) & 0x0000FFFF;
	GPSRange = Flash_Read(GPSRangeFlashAddress) & 0x0000FFFF;
	printf("Range : %d!!!!!!!!!!!!!!!!\r\n", GPSRange);

	printf("ModeFlag:%d", InfoModeFlag);
	if (InfoModeFlag >= 1) {
		DataFlashAddress = CallData(DataFlashAddress);
//		printf("\r\nbusStopID = %s\r\n\r\n", data[51].busRouteno);
//		strncpy(data[0].busStopID, "33333", sizeof(data[0].busStopID) - 1);
//		strncpy(data[0].lati, "36.391251", sizeof(data[0].lati) - 1);
//		strncpy(data[0].longi, "127.363235", sizeof(data[0].longi) - 1);
//
//		strncpy(data[1].busStopID, "44444", sizeof(data[1].busStopID) - 1);
//		strncpy(data[1].lati, "36.391567112", sizeof(data[1].lati) - 1);
//		strncpy(data[1].longi, "127.362770", sizeof(data[1].longi) - 1);

		//LCD_Write_Info(data[nowIdx], data[nowIdx + 1]);
	} else if (InfoModeFlag == 0) {
		LCD_SendCommand(LCD_ADDR, CMD_LCD_CLEAR); //Clear
		LCD_SendCommand(LCD_ADDR, CMD_LCD_CURSOR_LINE_1);
		LCD_SendString(LCD_ADDR, "DATA DOWNLOAD");
		LCD_SendCommand(LCD_ADDR, CMD_LCD_CURSOR_LINE_2);
		LCD_SendString(LCD_ADDR, "MODE");
	} else {
		InfoModeFlag = 0;
		Flash_Unlock();
		Flash_Write(ModeFlashAddress, 0);
		Flash_Lock();
	}

//	HAL_UARTEx_ReceiveToIdle_DMA(&huart3, (uint8_t*) RxBuffer, RxBuffer_SIZE);
//	__HAL_DMA_DISABLE_IT(&hdma_usart3_rx, DMA_IT_HT);
	int Serialcnt = 0;

	//LoRa ================================================================
	SetMode(0);



	//FW===================================================================
	modeFlag = HAL_GPIO_ReadPin(GPIOA, GPIO_PIN_15);

	GPSTick = HAL_GetTick();
	LoRaTick = HAL_GetTick();
	GPSFIXTick = HAL_GetTick();
	ArriveTick = HAL_GetTick();

	uint8_t IOMode = 0; //0 : In, 1 : Out
	uint8_t ArriveFlag = 0;

	int isPeopleFlag = 0;
	while(strncmp(data[nowIdx++].busStopID, "12400", 5) != 0);
	nowIdx--;
	updateLCD();

  /* USER CODE END 2 */

  /* Infinite loop */
  /* USER CODE BEGIN WHILE */
	while (1) {
//
//
//		HAL_GPIO_TogglePin(GPIOB, GPIO_PIN_9); //Debug LED
//		HAL_GPIO_TogglePin(GPIOB, GPIO_PIN_14); //GPS LED

		if (!modeFlag) { //Local Mode
//			if (InfoModeFlag >= 1) {
//				notGPSLCD();
//			}


			while (1) {
				if (UART1_Rx_End) {
					//printf("Echo: %s\r\n", UART1_Rx_Buffer);
					if (!strncmp(UART1_Rx_Buffer, "Input", 5)) {
						dataIdx = 0;
						DataFlashAddress = 0x0800CC00;
						Flash_Erase_Page(ModeFlashAddress);
						Flash_Unlock();
						Flash_Write(ModeFlashAddress, (uint8_t) 0);
						Flash_Lock();
						Flash_Clear();
						InfoModeFlag = 0;
						LCD_SendCommand(LCD_ADDR, CMD_LCD_CLEAR); //Clear
						LCD_SendCommand(LCD_ADDR, CMD_LCD_CURSOR_LINE_1);
						LCD_SendString(LCD_ADDR, "DATA DOWNLOAD");
						LCD_SendCommand(LCD_ADDR, CMD_LCD_CURSOR_LINE_2);
						LCD_SendString(LCD_ADDR, "MODE");
					} else if (!strncmp(UART1_Rx_Buffer, "OutPut", 6)) {
						Flash_Erase_Page(ModeFlashAddress);
						Flash_Unlock();
						Flash_Write(ModeFlashAddress, 1);
						Flash_Lock();
						InfoModeFlag = 1;
						LCD_SendCommand(LCD_ADDR, CMD_LCD_CLEAR); //Clear
						LCD_SendCommand(LCD_ADDR, CMD_LCD_CURSOR_LINE_1);
						LCD_SendString(LCD_ADDR, "DATA DOWNLOAD");
						LCD_SendCommand(LCD_ADDR, CMD_LCD_CURSOR_LINE_2);
						LCD_SendString(LCD_ADDR, "SUCCESS");
					} else if ((!strncmp(UART1_Rx_Buffer, "Da", 2)
							|| !strncmp(UART1_Rx_Buffer, "d", 1))
							&& InfoModeFlag == 0) {
						DataFlashAddress = Flash_Write_Data(DataFlashAddress,
								UART1_Rx_Buffer);
						//printf("Data\r\n");
						printf("N\r\n");
					} else if (!strncmp(UART1_Rx_Buffer, "range", 5)) {
						char *token;

						token = strtok(UART1_Rx_Buffer, ",");
						token = strtok(NULL, "!");
						GPSRange = atoi(token);

						Flash_Erase_Page(GPSRangeFlashAddress);
						Flash_Unlock();
						Flash_Write(GPSRangeFlashAddress, (uint8_t) GPSRange);
						Flash_Lock();
					}
					HAL_UART_Transmit(&huart1, UART1_Rx_Buffer, UART1_Len, 2);
					for (int i = 0; i < 50; i++) {
						UART1_Rx_Buffer[i] = '\0';
					}
					UART1_Len = 0;
					UART1_Rx_End = 0;
				}

				if (LoRaRxEnd) {
					printf("LoRa : %s, %d\r\n", LoRaRxData,
							strlen(LoRaRxData));
					parseLora(LoRaRxData);
					LoRa_SendData(LoRaRxData, sizeof(LoRaRxData) - 1);
					for (int i = 0; i < 11; i++) {
						LoRaRxData[i] = '\0';
					}
					LoRaLen = 0;
					LoRaRxEnd = 0;

				}

				if (InfoModeFlag) {
					if(loraFlag == 1){
						loraFlag = 0;
						if(data[nowIdx].isPeople == 2){
							helpBuzzer = 0;
						}
						if(data[nowIdx].isPeople == 1){
							for(int i = 0;i<4;i++){
								HAL_GPIO_TogglePin(GPIOB, GPIO_PIN_8);
								HAL_Delay(50);
							}
						}
						if(data[nowIdx].isPeople > 0 ){
							isPeopleFlag = 1;
						}
						else{
							isPeopleFlag = 0;
							HAL_GPIO_WritePin(GPIOA, GPIO_PIN_11, 0);
						}
						if(data[nowIdx+1].isPeople > 0){
							HAL_GPIO_WritePin(GPIOA, GPIO_PIN_12, 1); //LAMP2
						}
						else{
							HAL_GPIO_WritePin(GPIOA, GPIO_PIN_12, 0); //LAMP2
						}
					}

				if (HAL_GetTick() - ArriveTick >= 300) {
					ArriveTick = HAL_GetTick();
					HAL_GPIO_WritePin(GPIOB, GPIO_PIN_8, 0);
					if(isPeopleFlag){
						HAL_GPIO_TogglePin(GPIOA, GPIO_PIN_11);
					}
					if (helpBuzzer == 0 || helpBuzzer == 2 || helpBuzzer == 4) {

						HAL_GPIO_WritePin(GPIOB, GPIO_PIN_8, 1);
					}
					helpBuzzer++;
				}
//					if (dataReceived) {
//						parseGPSData(rxBuffer, RX3_BUFFER_SIZE);
//						dataReceived = 0;
//					}
//					if (HAL_GetTick() - GPSTick >= 1000) {
//						GPSTick = HAL_GetTick();
//						//printf("CNT : %d\r\n", checkGPSCnt);
//						if (checkGPSCnt >= 2) {
//							HAL_GPIO_WritePin(GPIOB, GPIO_PIN_8, 0); //BUZZER
//							if (IOMode == 0) {
//								LCD_Write_Arrive(data[nowIdx]);
//								HAL_GPIO_WritePin(GPIOB, GPIO_PIN_8, 1); //BUZZER
//								ArriveFlag = 1;
//								helpBuzzer = 0;
//							}
//
//							HAL_GPIO_TogglePin(GPIOB, GPIO_PIN_13); //Stop LED
//							IOMode = 1;
//						} else {
//							HAL_GPIO_WritePin(GPIOB, GPIO_PIN_8, 0); //BUZZER
//							if (IOMode == 1) {
//								nowIdx++;
//								updateLCD();
//								HAL_GPIO_WritePin(GPIOB, GPIO_PIN_8, 1); //BUZZER
//								ArriveFlag = 0;
//							}
//
//							HAL_GPIO_WritePin(GPIOB, GPIO_PIN_13, 0); //Stop LED
//							IOMode = 0;
//						}
//						checkGPSCnt = 0;
//					}

//					if (HAL_GetTick() - GPSFIXTick >= 100) {
//						//printf("%s\r\n", DataBuffer);
//						nmea_parse(&myData, DataBuffer);
//						if (myData.fix == 0) {
//							GPSFIXTick = HAL_GetTick();
//							HAL_GPIO_TogglePin(GPIOB, GPIO_PIN_14); //GPS LED
//							//printf("%d: No fix\r\n", Serialcnt);
//							Serialcnt++;
//						} else {
//							if (NowBusStopFlag == 0) {
//								if (myData.latitude > 0
//										&& myData.longitude > 0) {
//
//									//printf("%f, %f\r\n", myData.latitude, myData.longitude);
//									NowBusStop(myData.latitude,
//											myData.longitude);
//									updateLCD();
//								}
//							}
//							HAL_GPIO_WritePin(GPIOB, GPIO_PIN_14, 1); //GPS LED
////							printf("\r\n%d: Lat: %f %c, Lon: %f %c, Alt: %f m, Satellites: %d HDOP: %f\r\n",
////											Serialcnt, myData.latitude, myData.latSide, myData.longitude, myData.lonSide, myData.altitude, myData.satelliteCount, myData.hdop);
//							CheckGPS(myData.latitude, myData.longitude);
//						}
//					}
					if (HAL_GetTick() - BtnTick >= 2000 && pushingFlag) {
						pushingFlag = 0;
						upDownFlag = (upDownFlag + 1) % 2;
						HAL_GPIO_WritePin(GPIOB, GPIO_PIN_8, 1);
						HAL_Delay(100);
						HAL_GPIO_WritePin(GPIOB, GPIO_PIN_8, 0);
						if(nowIdx == 0){
							while(data[++nowIdx].busTP != '2');
						}
						else{
							nowIdx = 0;
						}
						updateLCD();
						if(data[nowIdx].isPeople == 2){
							helpBuzzer = 0;
						}
						if(data[nowIdx].isPeople == 1){
							for(int i = 0;i<4;i++){
								HAL_GPIO_TogglePin(GPIOB, GPIO_PIN_8);
								HAL_Delay(50);
							}
						}
						if(data[nowIdx].isPeople > 0 ){
							isPeopleFlag = 1;
						}
						else{
							isPeopleFlag = 0;
							HAL_GPIO_WritePin(GPIOA, GPIO_PIN_11, 0);
						}
						if(data[nowIdx+1].isPeople > 0){
							HAL_GPIO_WritePin(GPIOA, GPIO_PIN_12, 1); //LAMP2
						}
						else{
							HAL_GPIO_WritePin(GPIOA, GPIO_PIN_12, 0); //LAMP2
						}
					}
				}
//					if (NowBusStopFlag) {
//						if (HAL_GetTick() - ArriveTick >= 100) {
//							ArriveTick = HAL_GetTick();
//							printf("isPeople : %d\r\n", data[nowIdx].isPeople);
//							if (data[nowIdx].isPeople == 1) {
//								if (ArriveFlag == 1) {
//									HAL_GPIO_TogglePin(GPIOA, GPIO_PIN_11);
//								} else {
//									HAL_GPIO_WritePin(GPIOA, GPIO_PIN_11, 1); //LAMP1
//								}
//							}
//							if (data[nowIdx].isPeople == 2) {
//								if (ArriveFlag == 1) {
//									HAL_GPIO_TogglePin(GPIOA, GPIO_PIN_11);
//									if (helpBuzzer % 2 == 0
//											&& (helpBuzzer + 1) % 5
//											&& helpBuzzer < 11) {
//
//										HAL_GPIO_TogglePin(GPIOB, GPIO_PIN_8);
//									}
//									helpBuzzer++;
//								} else {
//									HAL_GPIO_WritePin(GPIOA, GPIO_PIN_11, 1); //LAMP1
//								}
//							}
//							if (data[nowIdx].isPeople == 0){
//								HAL_GPIO_WritePin(GPIOA, GPIO_PIN_11, 0); //LAMP1
//							}
//						}
//
//						if (data[nowIdx + 1].isPeople >= 1) {
//							HAL_GPIO_WritePin(GPIOA, GPIO_PIN_12, 1); //LAMP2
//						} else {
//							HAL_GPIO_WritePin(GPIOA, GPIO_PIN_12, 0); //LAMP2
//						}
//					}
				}
			}
		}

//		else { //Remote Mode
//			uint8_t data[] = "1,604,1315";
//			uint8_t data3[] = "000033333@";
//			uint8_t uartLoraFlag = 0;
//
//			while (1) {
//				if (UART1_Rx_End) {
//
//					//printf("Re:%s, %d!!!!\r\n", UART1_Rx_Buffer, strlen(UART1_Rx_Buffer));
//					char *token;
//
//					token = strtok(UART1_Rx_Buffer, "!");
//					strncpy(data, token, 10);
//					printf("\r\nRe:%s!!!!!\r\n\r\n", data);
//
//					token = strtok(NULL, "!");
//					strncpy(data3, token, 10);
//					printf("\r\nRe:%s!!!!!\r\n\r\n", data3);
//
//					for (int i = 0; i < 50; i++) {
//						UART1_Rx_Buffer[i] = '\0';
//					}
//					//LoRa_SendData(UART1_Rx_Buffer, strlen((char*)UART1_Rx_Buffer));
//					UART1_Len = 0;
//					UART1_Rx_End = 0;
//					uartLoraFlag = 1;
//					asd = 0;
//				}
//				if (LoRaRxEnd) {
//					printf("LoRa : %s, %d\r\n", LoRaRxData, strlen(LoRaRxData));
//					asd++;
//					for (int i = 0; i < 11; i++) {
//						LoRaRxData[i] = '\0';
//					}
//					LoRaLen = 0;
//					LoRaRxEnd = 0;
//				}
//				if (HAL_GetTick() - LoRaTick >= 3000 && uartLoraFlag == 1) {
//					LoRaTick = HAL_GetTick();
//					if (asd < 2) {
//						if (asd % 2 == 0) {
//							printf("data : %s\r\n", data);
//							LoRa_SendData(data, sizeof(data) - 1);
//							//printf("%s\r\n", data);
//						} else {
//							printf("data3 : %s\r\n", data3);
//							LoRa_SendData(data3, sizeof(data3) - 1);
//							//printf("%s\r\n", data3);
//						}
//					} else {
//						uartLoraFlag = 0;
//					}
//				}
//			}
//		}
//
//		HAL_Delay(100);
    /* USER CODE END WHILE */

    /* USER CODE BEGIN 3 */
	}
  /* USER CODE END 3 */


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
/* USER CODE BEGIN 4 */

void HAL_GPIO_EXTI_Callback(uint16_t GPIO_Pin) {
	if (GPIO_Pin == GPIO_PIN_5) {
		if (!modeFlag) { //LOCAL
			if (!HAL_GPIO_ReadPin(GPIOA, GPIO_PIN_5)) {
				BtnTick = HAL_GetTick();
				pushingFlag = 1;
			} else {
				pushingFlag = 0;
			}
		} else {
			if (!HAL_GPIO_ReadPin(GPIOA, GPIO_PIN_5)) {
				BtnTick = HAL_GetTick();
			} else {
				if (HAL_GetTick() - BtnTick < 2000) {
					printf("0x020,10x03\r\n");
				} else if (HAL_GetTick() - BtnTick < 5000) {
					printf("0x020,20x03\r\n");
				} else {
					printf("0x020,30x03\r\n");
				}
			}
		}
	} else if (GPIO_Pin == GPIO_PIN_6) {
		if (!HAL_GPIO_ReadPin(GPIOA, GPIO_PIN_6)) {
			BtnTick = HAL_GetTick();
		} else {
			if (HAL_GetTick() - BtnTick < 2000) {
				printf("0x021,10x03\r\n");
			} else if (HAL_GetTick() - BtnTick < 5000) {
				printf("0x021,20x03\r\n");
			} else {
				printf("0x021,30x03\r\n");
			}
		}
	} else if (GPIO_Pin == GPIO_PIN_7) {
		if (!HAL_GPIO_ReadPin(GPIOA, GPIO_PIN_7)) {
			BtnTick = HAL_GetTick();
		} else {
			if (HAL_GetTick() - BtnTick < 2000) {
				printf("0x022,10x03\r\n");
			} else if (HAL_GetTick() - BtnTick < 5000) {
				printf("0x022,20x03\r\n");
			} else {
				printf("0x022,30x03\r\n");
			}
		}
	} else if (GPIO_Pin == GPIO_PIN_0) {
		if (!HAL_GPIO_ReadPin(GPIOB, GPIO_PIN_0)) {
			BtnTick = HAL_GetTick();
		} else {
			if (HAL_GetTick() - BtnTick < 2000) {
				printf("0x023,10x03\r\n");
			} else if (HAL_GetTick() - BtnTick < 5000) {
				printf("0x023,20x03\r\n");
			} else {
				printf("0x023,30x03\r\n");
			}
		}
	} else if (GPIO_Pin == GPIO_PIN_1) {
		if (!HAL_GPIO_ReadPin(GPIOB, GPIO_PIN_1)) {
			BtnTick = HAL_GetTick();
		} else {
			if (HAL_GetTick() - BtnTick < 2000) {
				printf("0x024,10x03\r\n");
			} else if (HAL_GetTick() - BtnTick < 5000) {
				printf("0x024,20x03\r\n");
			} else {
				printf("0x024,30x03\r\n");
			}
		}
	}
}

void HAL_UART_RxCpltCallback(UART_HandleTypeDef *huart) {
	static uint8_t UART1_Chk = 0;
	static uint16_t index = 0;
	static uint8_t LoRaChk = 0;
	static uint16_t LoRaIdx = 0;
	if (huart->Instance == USART1) {
		UART1_Rx_End = 1;
//		switch (UART1_Chk) {
//		case 0:
//			if (UART1_Rx_Data[0] == 0x02) {
//				// Rx_Buffer[USART1_len]=UART1_Rx_Data[0];
//				// USART1_len++;
//				UART1_Chk = 1;
//			} else
//				UART1_Chk = 0;
//			break;
//		case 1:
//			if (UART1_Rx_Data[0] == 0x03) {
//				UART1_Rx_End = 1;
//				UART1_Chk = 0;
//			}
//			else {
//				UART1_Rx_Buffer[UART1_Len] = UART1_Rx_Data[0];
//				UART1_Len++;
//			}
//			break;
//		default:
//			UART1_Chk = 0;
//			break;
//		}
//		HAL_UART_Transmit(&huart1, UART1_Rx_Data, 1, 10);
//		HAL_UART_Receive_IT(&huart1, UART1_Rx_Data, 1);
	} else if (huart->Instance == USART2) {
		LoRaRxEnd = 1;
		HAL_UART_Receive_IT(&huart2, LoRaRxData, 10);

	} else if (huart->Instance == USART3) {
		dataReceived = 1;
	}
}

/* USER CODE END 4 */
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
