Minarinski/2024ESWContest_free_1079/(commit log)

2024-08-30 폴더 구성
2024-09-05 PCB 파일 업로드, 이미지 추가
    [bom.csv]
2024-09-05 Readme 수정
2024-09-05 Release EXE 파일 추가
2024-09-06 주석 unicode error해결
2024-10-11 예외처리 및 정류장 변경
2024-10-21 시연용 코드 개선
2024-10-21 시연용 F/W 개선
2024-10-21 txt 형식 변경
