Minarinski/2024ESWContest_free_1079/(notices)

Notices in the files:
MCU_Firmware/Core/Inc/main.h:
Copyright (c) 2024 STMicroelectronics.
All rights reserved.
This software is licensed under terms that can be found in the LICENSE file
